nicotakuya/diy_analogpad/diy_analogpad_schematics.png

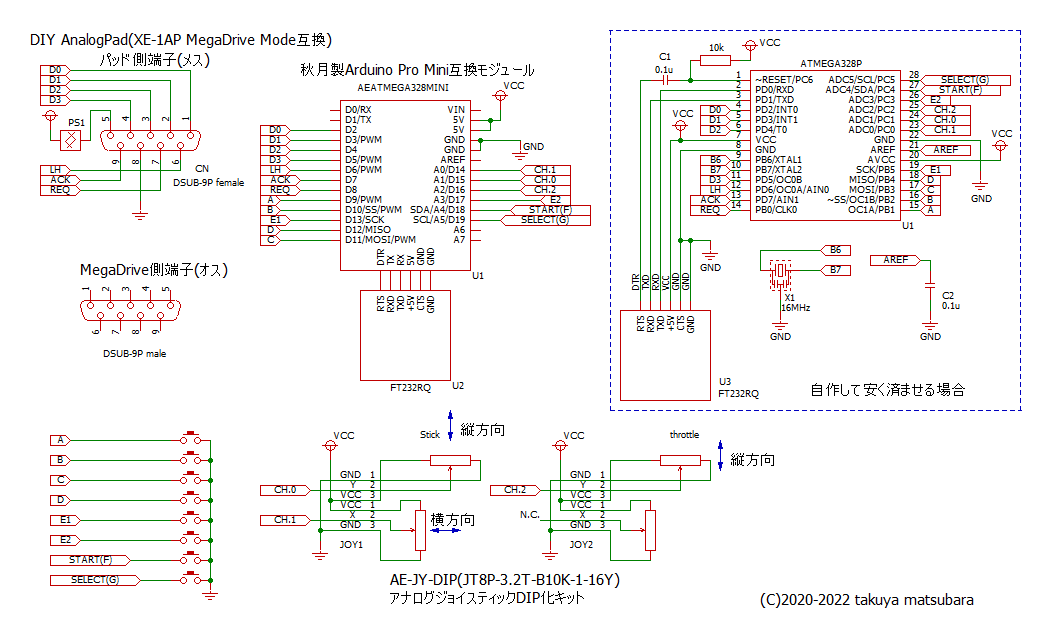
diy_analogpad_schematics.png
