nicotakuya/diy_analogpad/diy_analogpad_timing.png

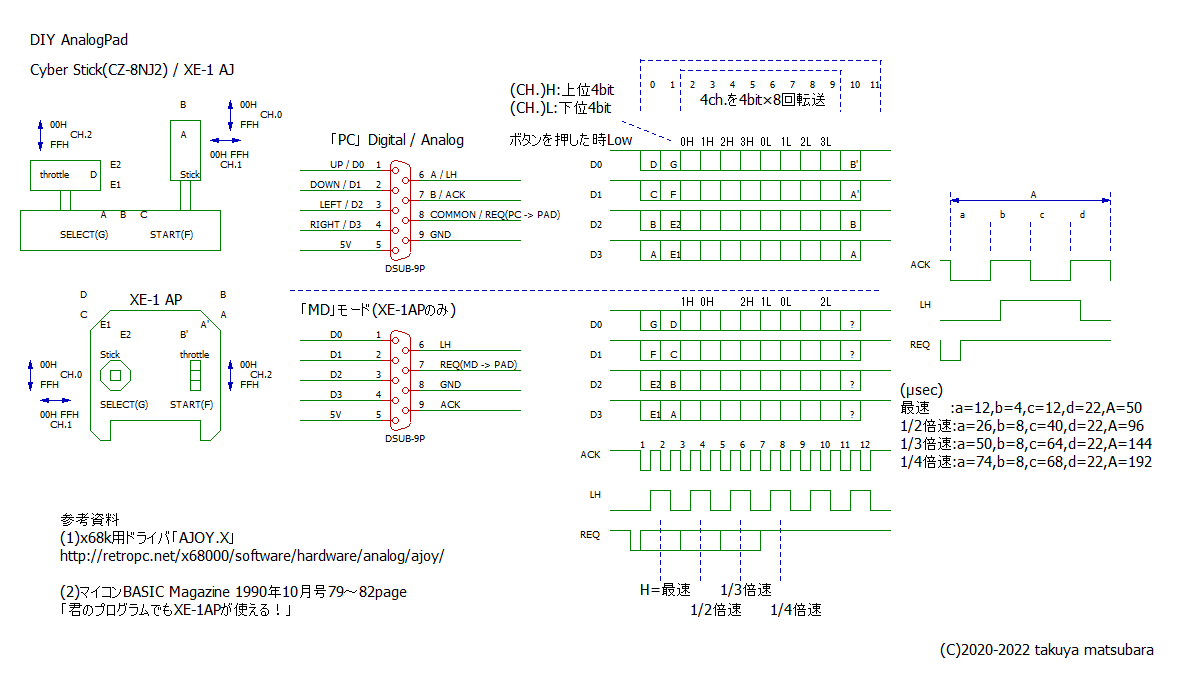
diy_analogpad_timing.png
