nicotakuya/diy_analogpad/(commit log)

2022-06-19 bug fix.
    analog CH0 and CH1 is switch.
    [MD_analogpad.ino]
2022-06-19 schematics
    schematics
